yetanothercarbot/the-ruby-node/TheRubyNode.kicad_pcb

## KiCad design TheRubyNode.kicad_pcb (2025-06-22)

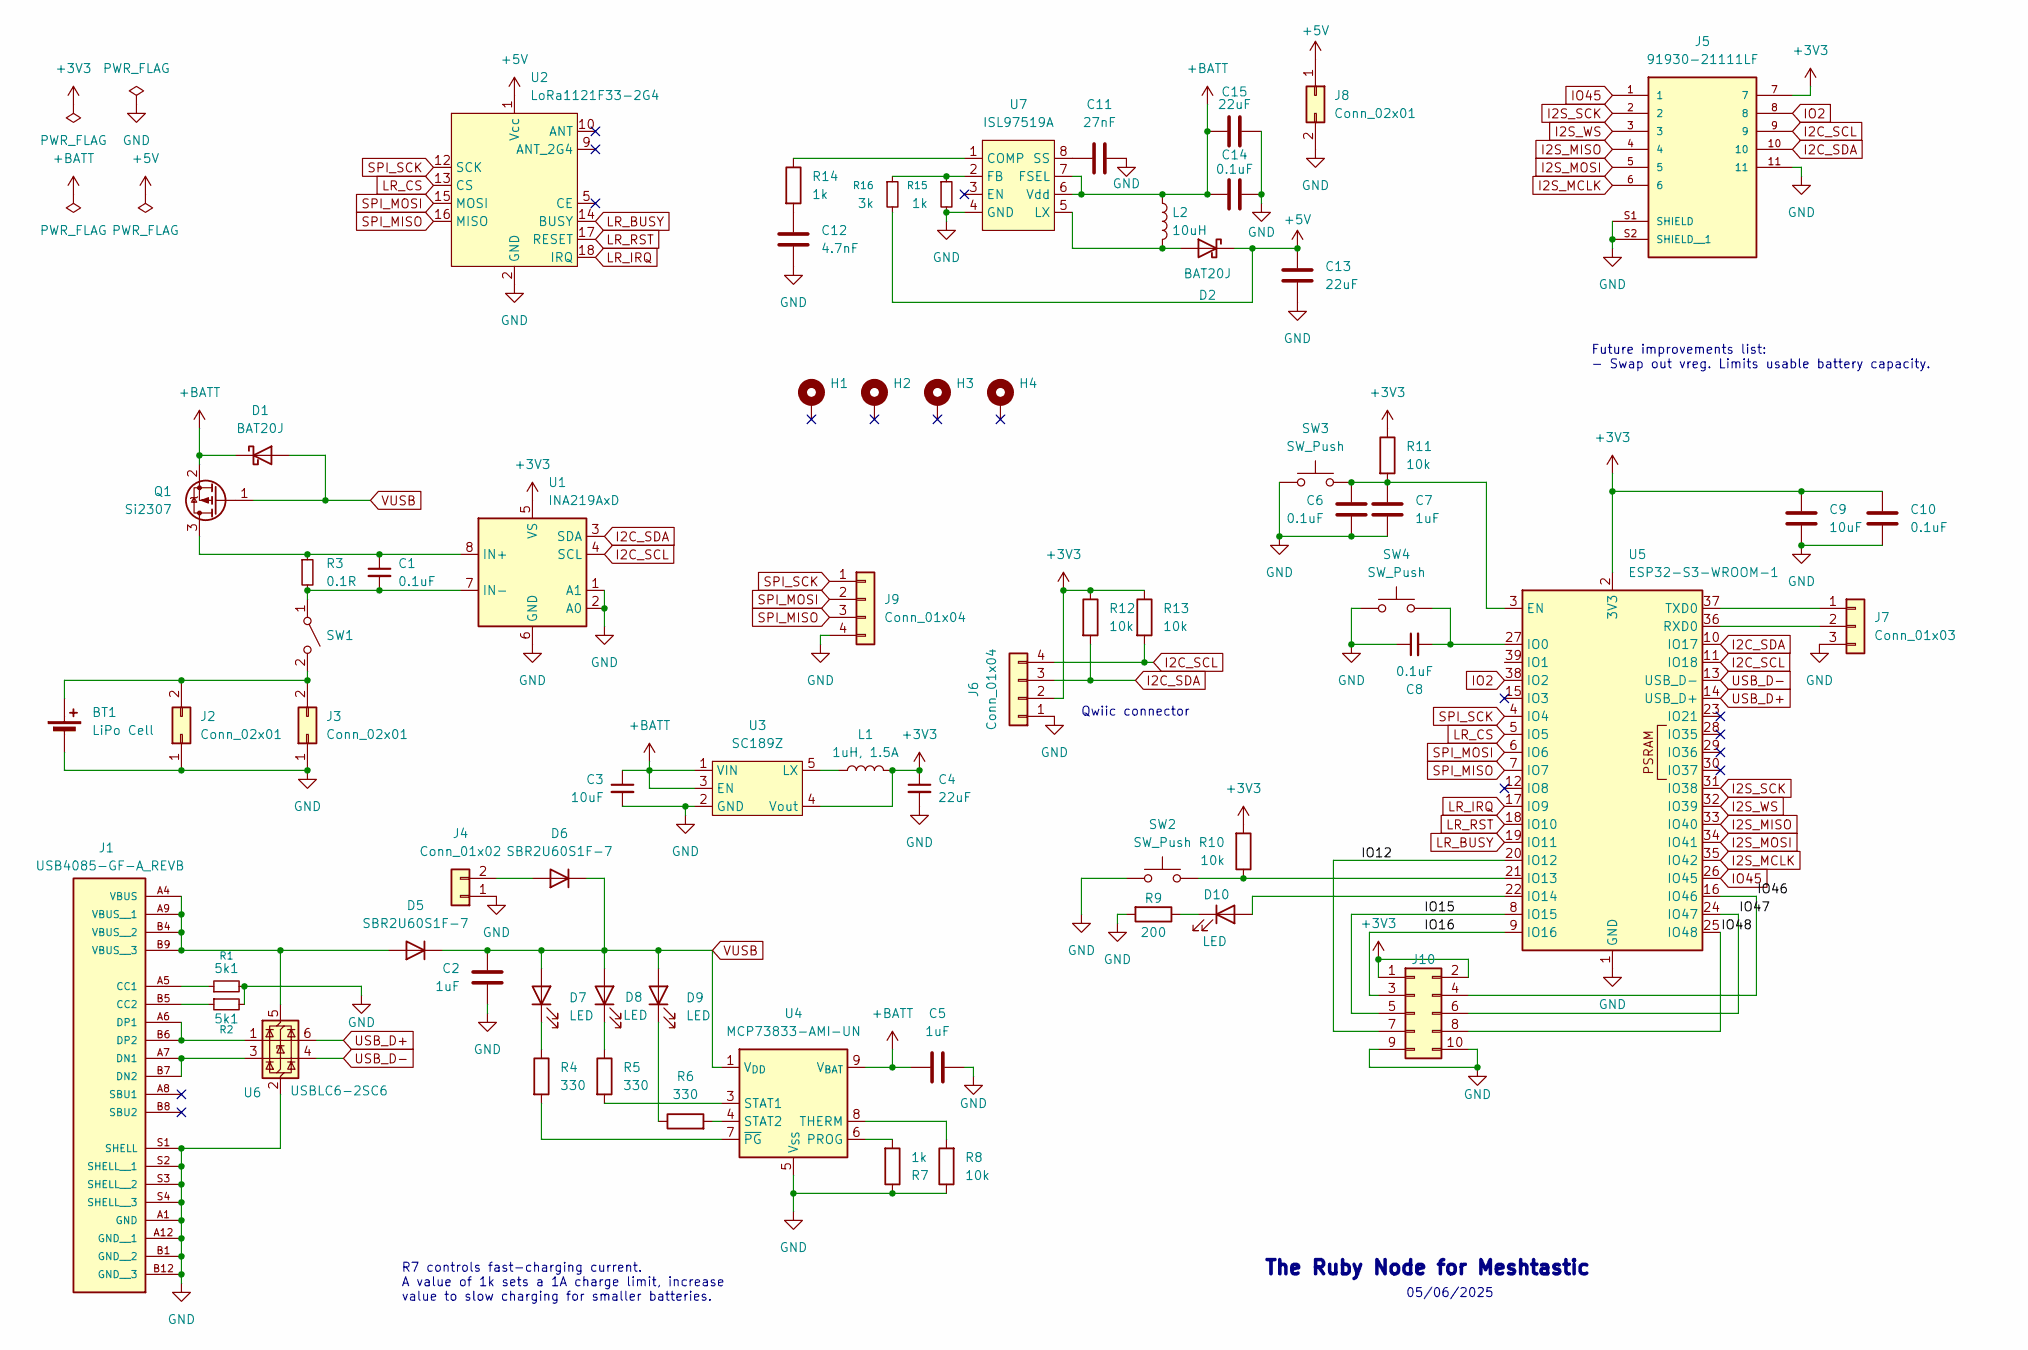
[picture p1: schematic TheRubyNode.kicad_sch]

Parts:
BT1: LiPo Cell; BatteryHolder_Keystone_1042_1x18650
C1, C6, C8, C10, C14: 0.1uF; C_0805_2012Metric_Pad1.18x1.45mm_HandSolder
C2, C5, C7: 1uF; C_0805_2012Metric_Pad1.18x1.45mm_HandSolder
C3, C9: 10uF; C_0805_2012Metric_Pad1.18x1.45mm_HandSolder
C4, C13, C15: 22uF; C_0805_2012Metric_Pad1.18x1.45mm_HandSolder
C11: 27nF; C_0805_2012Metric_Pad1.18x1.45mm_HandSolder
C12: 4.7nF; C_0805_2012Metric_Pad1.18x1.45mm_HandSolder
D1, D2: BAT20J; D_SOD-323_HandSoldering
D5, D6: SBR2U60S1F-7; D_SOD-123F
D7, D8, D9: LED; LED_1206_3216Metric_Pad1.42x1.75mm_HandSolder
D10: LED; LED_PLCC_2835_Handsoldering
H1, H2, H3, H4: MountingHole_Pad; MountingHole_3.2mm_M3_Pad
J1: USB4085-GF-A_REVB; GCT_USB4085-GF-A_REVB; PARTREV B
J2, J3: Conn_02x01; JST_PH_S2B-PH-SM4-TB_1x02-1MP_P2.00mm_Horizontal
J4: Conn_01x02; JST_PH_S2B-PH-SM4-TB_1x02-1MP_P2.00mm_Horizontal
J5: 91930-21111LF; AMPHENOL_91930-21111LF; PARTREV AN
J6: Conn_01x04; JST_SH_BM04B-SRSS-TB_1x04-1MP_P1.00mm_Vertical
J7: Conn_01x03; PinHeader_1x03_P2.54mm_Vertical
J8: Conn_02x01; JST_PH_B2B-PH-SM4-TB_1x02-1MP_P2.00mm_Vertical
J9: Conn_01x04; PinHeader_1x04_P2.54mm_Vertical
J10: Conn_02x05_Odd_Even; PinSocket_2x05_P2.54mm_Vertical
L1: 1uH, 1.5A; L_0805_2012Metric_Pad1.05x1.20mm_HandSolder
L2: 10uH; Inductor_2424
Q1: Si2307; SOT-23
R1, R2: 5k1; R_0805_2012Metric_Pad1.20x1.40mm_HandSolder
R3: 0.1R; R_2512_6332Metric_Pad1.40x3.35mm_HandSolder
R4, R5, R6: 330; R_0805_2012Metric_Pad1.20x1.40mm_HandSolder
R7, R14, R15: 1k; R_0805_2012Metric_Pad1.20x1.40mm_HandSolder
R8, R10, R11, R12, R13: 10k; R_0805_2012Metric_Pad1.20x1.40mm_HandSolder
R9: 200; R_0805_2012Metric_Pad1.20x1.40mm_HandSolder
R16: 3k; R_0805_2012Metric_Pad1.20x1.40mm_HandSolder
SW1: SW_SPST; JST_PH_B2B-PH-SM4-TB_1x02-1MP_P2.00mm_Vertical
SW2: SW_Push; JST_PH_B2B-PH-SM4-TB_1x02-1MP_P2.00mm_Vertical
SW3, SW4: SW_Push; SW_SPST_PTS645
U1: INA219AxD; SOIC-8_3.9x4.9mm_P1.27mm
U2: LoRa1121F33-2G4; LoRa1121F33
U3: SC189Z; SOT-23-5_HandSoldering
U4: MCP73833-AMI-UN; MSOP-10_3x3mm_P0.5mm
U5: ESP32-S3-WROOM-1; ESP32-S3-WROOM-1U
U6: USBLC6-2SC6; SOT-23-6
U7: ISL97519A; MSOP-8_3x3mm_P0.65mm

Connections:
+3V3: C4.1, C9.1, C10.1, J5.7, J6.2, J10.1, J10.2, L1.2, R10.2, R11.1, R12.1, R13.1, U1.5 (VS), U3.4 (Vout), U5.2 (3V3)
+5V: C13.1, D2.1 (K), J8.1, R16.2, U2.1 (Vcc)
+BATT: C3.1, C5.1, C14.1, C15.1, D1.1 (K), L2.1, Q1.2 (S), U3.1 (VIN), U3.3 (EN), U4.9 (V_{BAT}), U4.10 (V_{BAT}), U7.6 (Vdd), U7.7 (FSEL)
/IO12: J10.7, U5.20 (IO12)
/IO15: J10.5, U5.8 (IO15)
/IO16: J10.3, U5.9 (IO16)
/IO46: J10.4, U5.16 (IO46)
/IO47: J10.6, U5.24 (IO47)
/IO48: J10.8, U5.25 (IO48)
GND: BT1.2 (-), C2.2, C3.2, C4.2, C5.2, C6.2, C7.1, C8.1, C9.2, C10.2, C11.2, C12.2, C13.2, C14.2, C15.2, J1.A1 (GND), J1.A12 (GND__1), J1.B1 (GND__2), J1.B12 (GND__3), J1.S1 (SHELL), J1.S2 (SHELL__1), J1.S3 (SHELL__2), J1.S4 (SHELL__3), J2.1, J3.1, J4.1, J5.11, J5.S1 (SHIELD), J5.S2 (SHIELD__1), J6.1, J7.3, J8.2, J9.4, J10.9, J10.10, R1.2, R2.2, R7.1, R8.1, R9.2, R15.2, SW2.1, SW3.1, SW4.1, U1.1 (A1), U1.2 (A0), U1.6 (GND), U2.2 (GND), U2.3 (GND), U2.4 (GND), U2.6 (GND), U2.7 (GND), U2.8 (GND), U2.11 (GND), U2.19 (GND), U2.20 (GND), U3.2 (GND), U4.5 (V_{SS}), U5.1 (GND), U5.40 (GND), U5.41 (GND), U6.2 (GND), U7.4 (GND)
I2C_SCL: J5.9, J6.4, R13.2, U1.4 (SCL), U5.11 (IO18)
I2C_SDA: J5.10, J6.3, R12.2, U1.3 (SDA), U5.10 (IO17)
I2S_MCLK: J5.6, U5.35 (IO42)
I2S_MISO: J5.4, U5.33 (IO40)
I2S_MOSI: J5.5, U5.34 (IO41)
I2S_SCK: J5.2, U5.31 (IO38)
I2S_WS: J5.3, U5.32 (IO39)
IO2: J5.8, U5.38 (IO2)
IO45: J5.1, U5.26 (IO45)
LR_BUSY: U2.14 (BUSY), U5.19 (IO11)
LR_CS: U2.13 (CS), U5.5 (IO5)
LR_IRQ: U2.18 (IRQ), U5.17 (IO9)
LR_RST: U2.17 (RESET), U5.18 (IO10)
unnamed: BT1.1 (+), J2.2, J3.2, SW1.2 (B)
unnamed: C12.1, R14.2
unnamed: D2.2 (A), L2.2, U7.5 (LX)
unnamed: D5.2 (A), J1.A4 (VBUS), J1.A9 (VBUS__1), J1.B4 (VBUS__2), J1.B9 (VBUS__3), U6.5 (VBUS)
unnamed: D6.2 (A), J4.2
unnamed: D7.1 (K), R4.1
unnamed: D8.1 (K), R5.1
unnamed: D9.1 (K), R6.1
unnamed: D10.2 (A), U5.22 (IO14)
unnamed: D10.1 (K), R9.1
unnamed: J1.A5 (CC1), R1.1
unnamed: J1.B5 (CC2), R2.1
unnamed: J1.A7 (DN1), J1.B7 (DN2), U6.3 (I/O2)
unnamed: J1.A6 (DP1), J1.B6 (DP2), U6.1 (I/O1)
unnamed: J7.1, U5.37 (TXD0)
unnamed: J7.2, U5.36 (RXD0)
unnamed: C1.1, Q1.3 (D), R3.1, U1.8 (IN+)
unnamed: C1.2, R3.2, SW1.1 (A), U1.7 (IN-)
unnamed: L1.1, U3.5 (LX)
unnamed: R7.2, U4.6 (PROG)
unnamed: R5.2, U4.3 (STAT1)
unnamed: R6.2, U4.4 (STAT2)
unnamed: R8.2, U4.8 (THERM)
unnamed: R4.2, U4.7 (~PG)
unnamed: C6.1, C7.2, R11.2, SW3.2, U5.3 (EN)
unnamed: C8.2, SW4.2, U5.27 (IO0)
unnamed: R10.1, SW2.2, U5.21 (IO13)
unnamed: R14.1, U7.1 (COMP)
unnamed: R15.1, R16.1, U7.2 (FB)
unnamed: C11.1, U7.8 (SS)
SPI_MISO: J9.3, U2.16 (MISO), U5.7 (IO7)
SPI_MOSI: J9.2, U2.15 (MOSI), U5.6 (IO6)
SPI_SCK: J9.1, U2.12 (SCK), U5.4 (IO4)
USB_D+: U5.14 (USB_D+), U6.6 (I/O1)
USB_D-: U5.13 (USB_D-), U6.4 (I/O2)
VUSB: C2.1, D1.2 (A), D5.1 (K), D6.1 (K), D7.2 (A), D8.2 (A), D9.2 (A), Q1.1 (G), U4.1 (V_{DD}), U4.2 (V_{DD})

Notes on the sheet:
The Ruby Node for Meshtastic
R7 controls fast-charging current. A value of 1k sets a 1A charge limit, increase value to slow charging for smaller batteries.
05/06/2025
Future improvements list: - Swap out vreg. Limits usable battery capacity.
Qwiic connector

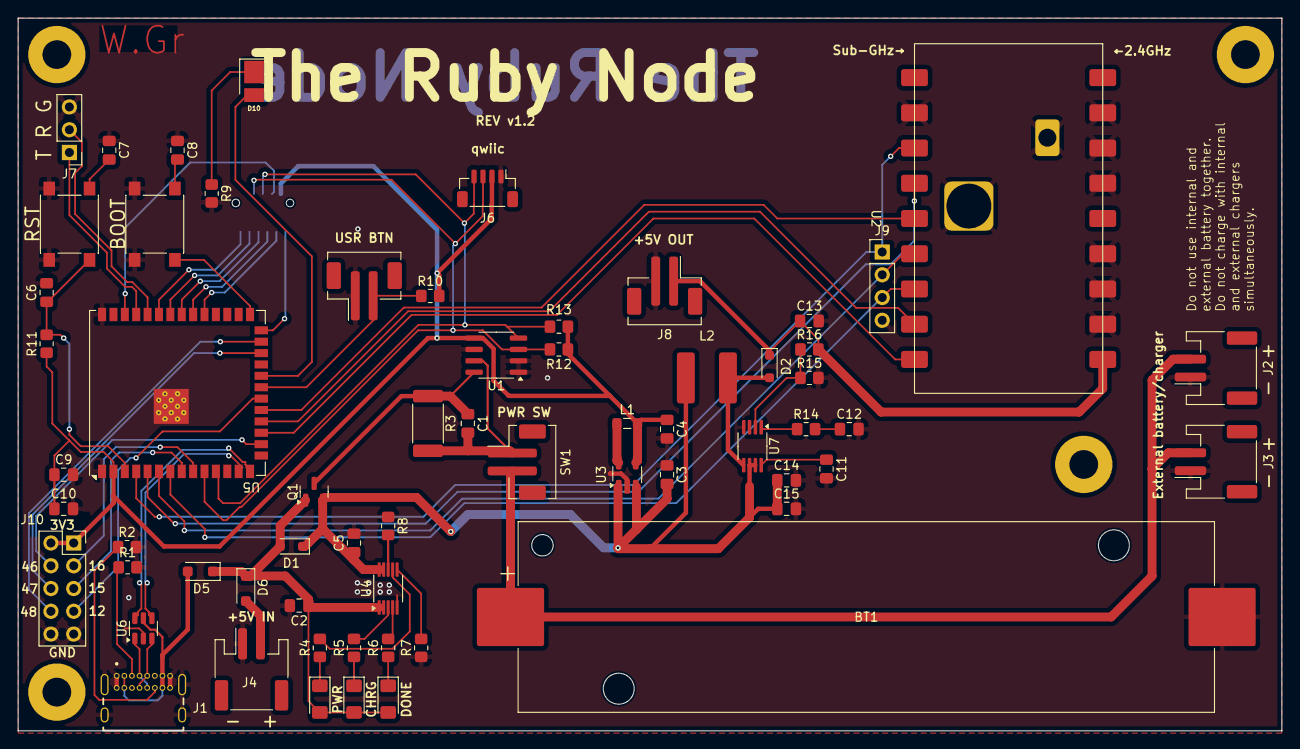
[picture p2: board TheRubyNode.kicad_pcb from above]

Board: 2 copper layers, 141.0 x 79.5 mm, 68 parts (1 on the bottom side), 59 nets.
