yetanothercarbot/the-ruby-node/(commit log)

2025-06-11 Finish footprints, start of pcb
    [TheRubyNode.kicad_pcb, TheRubyNode.kicad_sch]
2025-06-12 Add PCB design
    [TheRubyNode.kicad_sch, TheRubyNode_rounded.kicad_pcb]
2025-06-13 PCB layout changes (rounded)
    [TheRubyNode_rounded.kicad_pcb]
2025-06-16 Finalise rev 1.0 of PCB
    [TheRubyNode-rounded.kicad_pcb, TheRubyNode.kicad_pcb, TheRubyNode.kicad_sch]
2025-06-22 Break out additional IOs
    [TheRubyNode-rounded.kicad_pcb, TheRubyNode.kicad_pcb, TheRubyNode.kicad_sch]
2025-06-22 Add pin labels
    [TheRubyNode-rounded.kicad_pcb, TheRubyNode.kicad_pcb, TheRubyNode.kicad_sch]
